fallenwater/RT1064_MecanumWheel_Code/shiki_code/project/RT1064核心板丝印与芯片引脚对应表格.xlsx

GPIO编号 | PAD名称
RT1064 没有端口A
B0 | GPIO_AD_B0_00
B1 | GPIO_AD_B0_01
B2 | GPIO_AD_B0_02
B3 | GPIO_AD_B0_03
B4 | GPIO_AD_B0_04 | 核心板未引出
B5 | GPIO_AD_B0_05 | 核心板未引出
B6 | GPIO_AD_B0_06 | 核心板未引出
B7 | GPIO_AD_B0_07 | 核心板未引出
B8 | GPIO_AD_B0_08 | 核心板未引出
B9 | GPIO_AD_B0_09
B10 | GPIO_AD_B0_10
B11 | GPIO_AD_B0_11
B12 | GPIO_AD_B0_12
B13 | GPIO_AD_B0_13
B14 | GPIO_AD_B0_14
B15 | GPIO_AD_B0_15
B16 | GPIO_AD_B1_00
B17 | GPIO_AD_B1_01
B18 | GPIO_AD_B1_02
B19 | GPIO_AD_B1_03
B20 | GPIO_AD_B1_04
B21 | GPIO_AD_B1_05
B22 | GPIO_AD_B1_06
B23 | GPIO_AD_B1_07
B24 | GPIO_AD_B1_08
B25 | GPIO_AD_B1_09
B26 | GPIO_AD_B1_10
B27 | GPIO_AD_B1_11
B28 | GPIO_AD_B1_12
B29 | GPIO_AD_B1_13
B30 | GPIO_AD_B1_14
B31 | GPIO_AD_B1_15
C0 | GPIO_B0_00
C1 | GPIO_B0_01
C2 | GPIO_B0_02
C3 | GPIO_B0_03
C4 | GPIO_B0_04
C5 | GPIO_B0_05
C6 | GPIO_B0_06
C7 | GPIO_B0_07
C8 | GPIO_B0_08
C9 | GPIO_B0_09
C10 | GPIO_B0_10
C11 | GPIO_B0_11
C12 | GPIO_B0_12
C13 | GPIO_B0_13
C14 | GPIO_B0_14
C15 | GPIO_B0_15
C16 | GPIO_B1_00
C17 | GPIO_B1_01
C18 | GPIO_B1_02
C19 | GPIO_B1_03
C20 | GPIO_B1_04
C21 | GPIO_B1_05
C22 | GPIO_B1_06
C23 | GPIO_B1_07
C24 | GPIO_B1_08
C25 | GPIO_B1_09
C26 | GPIO_B1_10
C27 | GPIO_B1_11
C28 | GPIO_B1_12
C29 | GPIO_B1_13
C30 | GPIO_B1_14
C31 | GPIO_B1_15
D0 | GPIO_SD_B1_00
D1 | GPIO_SD_B1_01
D2 | GPIO_SD_B1_02
D3 | GPIO_SD_B1_03
D4 | GPIO_SD_B1_04
D5 | GPIO_SD_B1_05 | 核心板未引出
D6 | GPIO_SD_B1_06 | 核心板未引出
D7 | GPIO_SD_B1_07 | 核心板未引出
D8 | GPIO_SD_B1_08 | 核心板未引出
D9 | GPIO_SD_B1_09 | 核心板未引出
D10 | GPIO_SD_B1_10 | 核心板未引出
D11 | GPIO_SD_B1_11 | 核心板未引出
D12 | GPIO_SD_B0_00
D13 | GPIO_SD_B0_01
D14 | GPIO_SD_B0_02
D15 | GPIO_SD_B0_03
D16 | GPIO_SD_B0_04
D17 | GPIO_SD_B0_05
D18 | GPIO_EMC_32 | 核心板未引出
D19 | GPIO_EMC_33 | 核心板未引出
D20 | GPIO_EMC_34 | 核心板未引出
D21 | GPIO_EMC_35 | 核心板未引出
D22 | GPIO_EMC_36 | 核心板未引出
D23 | GPIO_EMC_37 | 核心板未引出
D24 | GPIO_EMC_38 | 核心板未引出
D25 | GPIO_EMC_39 | 核心板未引出
D26 | GPIO_EMC_40
D27 | GPIO_EMC_41
D28 | 无此引脚
D29 | 无此引脚
D30 | 无此引脚
D31 | 无此引脚
E0 | GPIO_EMC_00 | E端口被SDRAM占用因此全部未引出
E1 | GPIO_EMC_01 | E端口被SDRAM占用因此全部未引出
E2 | GPIO_EMC_02 | E端口被SDRAM占用因此全部未引出
E3 | GPIO_EMC_03 | E端口被SDRAM占用因此全部未引出
E4 | GPIO_EMC_04 | E端口被SDRAM占用因此全部未引出
E5 | GPIO_EMC_05 | E端口被SDRAM占用因此全部未引出
E6 | GPIO_EMC_06 | E端口被SDRAM占用因此全部未引出
E7 | GPIO_EMC_07 | E端口被SDRAM占用因此全部未引出
E8 | GPIO_EMC_08 | E端口被SDRAM占用因此全部未引出
E9 | GPIO_EMC_09 | E端口被SDRAM占用因此全部未引出
E10 | GPIO_EMC_10 | E端口被SDRAM占用因此全部未引出
E11 | GPIO_EMC_11 | E端口被SDRAM占用因此全部未引出
E12 | GPIO_EMC_12 | E端口被SDRAM占用因此全部未引出
E13 | GPIO_EMC_13 | E端口被SDRAM占用因此全部未引出
E14 | GPIO_EMC_14 | E端口被SDRAM占用因此全部未引出
E15 | GPIO_EMC_15 | E端口被SDRAM占用因此全部未引出
E16 | GPIO_EMC_16 | E端口被SDRAM占用因此全部未引出
E17 | GPIO_EMC_17 | E端口被SDRAM占用因此全部未引出
E18 | GPIO_EMC_18 | E端口被SDRAM占用因此全部未引出
E19 | GPIO_EMC_19 | E端口被SDRAM占用因此全部未引出
E20 | GPIO_EMC_20 | E端口被SDRAM占用因此全部未引出
E21 | GPIO_EMC_21 | E端口被SDRAM占用因此全部未引出
E22 | GPIO_EMC_22 | E端口被SDRAM占用因此全部未引出
E23 | GPIO_EMC_23 | E端口被SDRAM占用因此全部未引出
E24 | GPIO_EMC_24 | E端口被SDRAM占用因此全部未引出
E25 | GPIO_EMC_25 | E端口被SDRAM占用因此全部未引出
E26 | GPIO_EMC_26 | E端口被SDRAM占用因此全部未引出
E27 | GPIO_EMC_27 | E端口被SDRAM占用因此全部未引出
E28 | GPIO_EMC_28 | E端口被SDRAM占用因此全部未引出
E29 | GPIO_EMC_29 | E端口被SDRAM占用因此全部未引出
E30 | GPIO_EMC_30 | E端口被SDRAM占用因此全部未引出
E31 | GPIO_EMC_31 | E端口被SDRAM占用因此全部未引出
F0 | SNVS_WAKEUP | 特殊引脚核心板未引出
F1 | SNVS_PMIC_ON_REQ | 特殊引脚核心板未引出
F2 | SNVS_PMIC_STBY_REQ | 特殊引脚核心板未引出
