fallenwater/RT1064_MecanumWheel_Code/(list of files, drawings)

Other design files:
pcb/DRV8701视觉双驱（1）.eprj
pcb/RT1064主板.eprj
