fallenwater/RT1064_MecanumWheel_Code/shiki_code/project/hardware/tft180.h

#ifndef _TFT180_H_
#define _TFT180_H_

#include "zf_common_typedef.h"
#include "zf_device_tft180.h"
#include "zf_common_font.h"

void my_tft180_init(tft180_dir_enum disp_dir, tft180_font_size_enum disp_font, rgb565_color_enum disp_font_color, rgb565_color_enum disp_background_color);



#endif
