fallenwater/RT1064_MecanumWheel_Code/shiki_code/project/hardware/wireless_uart.h

/* **************************************************************************************************
*****************************************************************************************************
***************																		  ***************	
***************		     因为无线串口完全用于vofa，所以代码已经全部移植到vofa.h		  ***************
***************																		  ***************
*****************************************************************************************************
************************************************************************************************** */


//#ifndef _WIRELESS_UART_H
//#define _WIRELESS_UART_H

//#include "zf_device_wireless_uart.h"
//#include "zf_driver_delay.h"
//#include "zf_common_typedef.h"
//#include <stdint.h> 

//#define CoreBoard_LED					(B9)

//extern volatile int32_t vofa_enc_snapshot[4];
//extern volatile bool vofa_enc_ready;


//void my_wireless_init(void);
//void vofa_send_task(void);		// 无限串口发送vofa数据获取数据




//#endif
