fallenwater/RT1064_MecanumWheel_Code/shiki_code/project/user/inc/total_headfile.h

/*-----------------------------------逐飞官方头文件----------------------------------------------*/
#include "zf_common_headfile.h"


/*-----------------------------------自定义驱动头文件----------------------------------------------*/
#include "uart.h"				// 自定义串口	配置
#include "PWM.h"				// PWM      	配置
#include "Motor.h"				// 电机驱动    	配置
#include "encoder.h"			// 编码器		配置
#include "wireless_uart.h"		// 无线串口		配置
#include "tft180.h"				// tft180初始化	配置
#include "tft180_font_image.h"	// 自定义图像文字配置
#include "Switch.h"				// 自定义开关按键配置
#include "imu660ra.h"			// 陀螺仪 		配置

/*-----------------------------------自定义算法头文件----------------------------------------------*/
#include "vofa.h"				// 无线串口vofa调参
#include "PID.h"				// PID算法和初始化
#include "PID_Control.h"		// PID多环调用控制
#include "MCar_Control.h"		// 麦轮控制算法
#include "UI.h"					// tft180 图像UI



/*-----------------------------------初始化头文件----------------------------------------------*/
#include "total_init.h"			// 全文件初始化与PIT中断函数
