fallenwater/RT1064_MecanumWheel_Code/(commit log)

2026-11-03 RT1064 麦克纳姆轮完整代码（PCB + 源码）
    [DRV8701视觉双驱（1）.eprj, RT1064主板.eprj, RT1064核心板丝印与芯片引脚对应表格.xlsx]
2026-11-05 Add README for RT1064 chassis control system
    Add detailed README for RT1064 omnidirectional chassis control system, including features, hardware platform, directory structure, control architecture, and debugging methods.
