fallenwater/RT1064_MecanumWheel_Code/(notices)

Notices in the files:
shiki_code/project/user/src/isr.c:
Copyright (c) 2022 SEEKFREE Öð·É¿Æ¼¼
